Ahan-Trivedi2/mosfet-dac/test_dac1.txt

 yes             code            v(sb0)          v(sb1)          v(sb2)          v(sb3)          v(sb4)          v(sb5)          v(sb6)          i(Viout)        v(Vout)        
 1.00000000e+00  0.00000000e+00  0.00000000e+00  0.00000000e+00  0.00000000e+00  0.00000000e+00  0.00000000e+00  0.00000000e+00  0.00000000e+00  1.82866334e-07  2.00000000e-01 
 1.00000000e+00  1.00000000e+00  1.26118649e+00  0.00000000e+00  0.00000000e+00  0.00000000e+00  0.00000000e+00  0.00000000e+00  0.00000000e+00  1.87715440e-07  2.00000000e-01 
 1.00000000e+00  2.00000000e+00  0.00000000e+00  1.26118647e+00  0.00000000e+00  0.00000000e+00  0.00000000e+00  0.00000000e+00  0.00000000e+00  1.92816409e-07  2.00000000e-01 
 1.00000000e+00  3.00000000e+00  1.26118652e+00  1.26118652e+00  0.00000000e+00  0.00000000e+00  0.00000000e+00  0.00000000e+00  0.00000000e+00  1.97860644e-07  2.00000000e-01 
 1.00000000e+00  4.00000000e+00  0.00000000e+00  0.00000000e+00  1.26118648e+00  0.00000000e+00  0.00000000e+00  0.00000000e+00  0.00000000e+00  2.03180927e-07  2.00000000e-01 
 1.00000000e+00  5.00000000e+00  1.26118653e+00  0.00000000e+00  1.26118653e+00  0.00000000e+00  0.00000000e+00  0.00000000e+00  0.00000000e+00  2.08109976e-07  2.00000000e-01 
 1.00000000e+00  6.00000000e+00  0.00000000e+00  1.26118652e+00  1.26118652e+00  0.00000000e+00  0.00000000e+00  0.00000000e+00  0.00000000e+00  2.13316512e-07  2.00000000e-01 
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
 1.00000000e+00  3.90000000e+01  1.26118661e+00  1.26118661e+00  1.26118661e+00  0.00000000e+00  0.00000000e+00  1.26118661e+00  0.00000000e+00  3.89177282e-07  2.00000000e-01 
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
