Ahan-Trivedi2/mosfet-dac/test_dac10.txt

 yes             code            v(sb0)          v(sb1)          v(sb2)          v(sb3)          v(sb4)          v(sb5)          v(sb6)          i(Viout)        v(Vout)        
 1.00000000e+00  0.00000000e+00  0.00000000e+00  0.00000000e+00  0.00000000e+00  0.00000000e+00  0.00000000e+00  0.00000000e+00  0.00000000e+00  1.34841469e-07  2.00000000e-01 
 1.00000000e+00  1.00000000e+00  1.23102774e+00  0.00000000e+00  0.00000000e+00  0.00000000e+00  0.00000000e+00  0.00000000e+00  0.00000000e+00  1.38862307e-07  2.00000000e-01 
 1.00000000e+00  2.00000000e+00  0.00000000e+00  1.23102773e+00  0.00000000e+00  0.00000000e+00  0.00000000e+00  0.00000000e+00  0.00000000e+00  1.43320082e-07  2.00000000e-01 
 1.00000000e+00  3.00000000e+00  1.23102779e+00  1.23102779e+00  0.00000000e+00  0.00000000e+00  0.00000000e+00  0.00000000e+00  0.00000000e+00  1.47491604e-07  2.00000000e-01 
 1.00000000e+00  4.00000000e+00  0.00000000e+00  0.00000000e+00  1.23102773e+00  0.00000000e+00  0.00000000e+00  0.00000000e+00  0.00000000e+00  1.52126862e-07  2.00000000e-01 
 1.00000000e+00  5.00000000e+00  1.23102779e+00  0.00000000e+00  1.23102779e+00  0.00000000e+00  0.00000000e+00  0.00000000e+00  0.00000000e+00  1.56183434e-07  2.00000000e-01 
 1.00000000e+00  6.00000000e+00  0.00000000e+00  1.23102778e+00  1.23102778e+00  0.00000000e+00  0.00000000e+00  0.00000000e+00  0.00000000e+00  1.60726109e-07  2.00000000e-01 
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
 1.00000000e+00  3.90000000e+01  1.23102789e+00  1.23102789e+00  1.23102789e+00  0.00000000e+00  0.00000000e+00  1.23102789e+00  0.00000000e+00  3.08332166e-07  2.00000000e-01 
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
