Ahan-Trivedi2/mosfet-dac/test_dac2.txt

 yes             code            v(sb0)          v(sb1)          v(sb2)          v(sb3)          v(sb4)          v(sb5)          v(sb6)          i(Viout)        v(Vout)        
 1.00000000e+00  0.00000000e+00  0.00000000e+00  0.00000000e+00  0.00000000e+00  0.00000000e+00  0.00000000e+00  0.00000000e+00  0.00000000e+00  8.42489442e-08  2.00000000e-01 
 1.00000000e+00  1.00000000e+00  1.17058799e+00  0.00000000e+00  0.00000000e+00  0.00000000e+00  0.00000000e+00  0.00000000e+00  0.00000000e+00  8.35890432e-08  2.00000000e-01 
 1.00000000e+00  2.00000000e+00  0.00000000e+00  1.17058798e+00  0.00000000e+00  0.00000000e+00  0.00000000e+00  0.00000000e+00  0.00000000e+00  8.59487441e-08  2.00000000e-01 
 1.00000000e+00  3.00000000e+00  1.17058807e+00  1.17058807e+00  0.00000000e+00  0.00000000e+00  0.00000000e+00  0.00000000e+00  0.00000000e+00  8.67917785e-08  2.00000000e-01 
 1.00000000e+00  4.00000000e+00  0.00000000e+00  0.00000000e+00  1.17058799e+00  0.00000000e+00  0.00000000e+00  0.00000000e+00  0.00000000e+00  9.05680955e-08  2.00000000e-01 
 1.00000000e+00  5.00000000e+00  1.17058808e+00  0.00000000e+00  1.17058808e+00  0.00000000e+00  0.00000000e+00  0.00000000e+00  0.00000000e+00  9.06353794e-08  2.00000000e-01 
 1.00000000e+00  6.00000000e+00  0.00000000e+00  1.17058807e+00  1.17058807e+00  0.00000000e+00  0.00000000e+00  0.00000000e+00  0.00000000e+00  9.37514247e-08  2.00000000e-01 
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
 1.00000000e+00  3.90000000e+01  1.17058826e+00  1.17058826e+00  1.17058826e+00  0.00000000e+00  0.00000000e+00  1.17058826e+00  0.00000000e+00  1.68637335e-07  2.00000000e-01 
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
