Ahan-Trivedi2/mosfet-dac/test_dac3.txt

 yes             code            v(sb0)          v(sb1)          v(sb2)          v(sb3)          v(sb4)          v(sb5)          v(sb6)          i(Viout)        v(Vout)        
 1.00000000e+00  0.00000000e+00  0.00000000e+00  0.00000000e+00  0.00000000e+00  0.00000000e+00  0.00000000e+00  0.00000000e+00  0.00000000e+00  1.59955095e-07  2.00000000e-01 
 1.00000000e+00  1.00000000e+00  1.25888984e+00  0.00000000e+00  0.00000000e+00  0.00000000e+00  0.00000000e+00  0.00000000e+00  0.00000000e+00  1.62700293e-07  2.00000000e-01 
 1.00000000e+00  2.00000000e+00  0.00000000e+00  1.25888984e+00  0.00000000e+00  0.00000000e+00  0.00000000e+00  0.00000000e+00  0.00000000e+00  1.68397689e-07  2.00000000e-01 
 1.00000000e+00  3.00000000e+00  1.25888988e+00  1.25888988e+00  0.00000000e+00  0.00000000e+00  0.00000000e+00  0.00000000e+00  0.00000000e+00  1.72478815e-07  2.00000000e-01 
 1.00000000e+00  4.00000000e+00  0.00000000e+00  0.00000000e+00  1.25888984e+00  0.00000000e+00  0.00000000e+00  0.00000000e+00  0.00000000e+00  1.79533950e-07  2.00000000e-01 
 1.00000000e+00  5.00000000e+00  1.25888988e+00  0.00000000e+00  1.25888988e+00  0.00000000e+00  0.00000000e+00  0.00000000e+00  0.00000000e+00  1.82899106e-07  2.00000000e-01 
 1.00000000e+00  6.00000000e+00  0.00000000e+00  1.25888988e+00  1.25888988e+00  0.00000000e+00  0.00000000e+00  0.00000000e+00  0.00000000e+00  1.89250864e-07  2.00000000e-01 
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
 1.00000000e+00  3.90000000e+01  1.25888996e+00  1.25888996e+00  1.25888996e+00  0.00000000e+00  0.00000000e+00  1.25888996e+00  0.00000000e+00  3.68475863e-07  2.00000000e-01 
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
