Ahan-Trivedi2/mosfet-dac/test_dac4.txt

 yes             code            v(sb0)          v(sb1)          v(sb2)          v(sb3)          v(sb4)          v(sb5)          v(sb6)          i(Viout)        v(Vout)        
 1.00000000e+00  0.00000000e+00  0.00000000e+00  0.00000000e+00  0.00000000e+00  0.00000000e+00  0.00000000e+00  0.00000000e+00  0.00000000e+00  1.81093937e-07  2.00000000e-01 
 1.00000000e+00  1.00000000e+00  1.24883757e+00  0.00000000e+00  0.00000000e+00  0.00000000e+00  0.00000000e+00  0.00000000e+00  0.00000000e+00  1.93640272e-07  2.00000000e-01 
 1.00000000e+00  2.00000000e+00  0.00000000e+00  1.24883757e+00  0.00000000e+00  0.00000000e+00  0.00000000e+00  0.00000000e+00  0.00000000e+00  1.98269781e-07  2.00000000e-01 
 1.00000000e+00  3.00000000e+00  1.24883763e+00  1.24883763e+00  0.00000000e+00  0.00000000e+00  0.00000000e+00  0.00000000e+00  0.00000000e+00  2.06794864e-07  2.00000000e-01 
 1.00000000e+00  4.00000000e+00  0.00000000e+00  0.00000000e+00  1.24883757e+00  0.00000000e+00  0.00000000e+00  0.00000000e+00  0.00000000e+00  2.07263137e-07  2.00000000e-01 
 1.00000000e+00  5.00000000e+00  1.24883762e+00  0.00000000e+00  1.24883762e+00  0.00000000e+00  0.00000000e+00  0.00000000e+00  0.00000000e+00  2.17762711e-07  2.00000000e-01 
 1.00000000e+00  6.00000000e+00  0.00000000e+00  1.24883762e+00  1.24883762e+00  0.00000000e+00  0.00000000e+00  0.00000000e+00  0.00000000e+00  2.20367754e-07  2.00000000e-01 
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
 1.00000000e+00  3.90000000e+01  1.24883772e+00  1.24883772e+00  1.24883772e+00  0.00000000e+00  0.00000000e+00  1.24883772e+00  0.00000000e+00  3.80235184e-07  2.00000000e-01 
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
