Ahan-Trivedi2/mosfet-dac/test_dac5.txt

 yes             code            v(sb0)          v(sb1)          v(sb2)          v(sb3)          v(sb4)          v(sb5)          v(sb6)          i(Viout)        v(Vout)        
 1.00000000e+00  0.00000000e+00  0.00000000e+00  0.00000000e+00  0.00000000e+00  0.00000000e+00  0.00000000e+00  0.00000000e+00  0.00000000e+00  1.21390231e-07  2.00000000e-01 
 1.00000000e+00  1.00000000e+00  1.21446133e+00  0.00000000e+00  0.00000000e+00  0.00000000e+00  0.00000000e+00  0.00000000e+00  0.00000000e+00  1.25894581e-07  2.00000000e-01 
 1.00000000e+00  2.00000000e+00  0.00000000e+00  1.21446134e+00  0.00000000e+00  0.00000000e+00  0.00000000e+00  0.00000000e+00  0.00000000e+00  1.29960938e-07  2.00000000e-01 
 1.00000000e+00  3.00000000e+00  1.21446141e+00  1.21446141e+00  0.00000000e+00  0.00000000e+00  0.00000000e+00  0.00000000e+00  0.00000000e+00  1.34197710e-07  2.00000000e-01 
 1.00000000e+00  4.00000000e+00  0.00000000e+00  0.00000000e+00  1.21446133e+00  0.00000000e+00  0.00000000e+00  0.00000000e+00  0.00000000e+00  1.38080610e-07  2.00000000e-01 
 1.00000000e+00  5.00000000e+00  1.21446140e+00  0.00000000e+00  1.21446140e+00  0.00000000e+00  0.00000000e+00  0.00000000e+00  0.00000000e+00  1.42436621e-07  2.00000000e-01 
 1.00000000e+00  6.00000000e+00  0.00000000e+00  1.21446141e+00  1.21446141e+00  0.00000000e+00  0.00000000e+00  0.00000000e+00  0.00000000e+00  1.46400872e-07  2.00000000e-01 
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
 1.00000000e+00  3.90000000e+01  1.21446154e+00  1.21446154e+00  1.21446154e+00  0.00000000e+00  0.00000000e+00  1.21446154e+00  0.00000000e+00  2.79807840e-07  2.00000000e-01 
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
