Ahan-Trivedi2/mosfet-dac/test_dac6.txt

 yes             code            v(sb0)          v(sb1)          v(sb2)          v(sb3)          v(sb4)          v(sb5)          v(sb6)          i(Viout)        v(Vout)        
 1.00000000e+00  0.00000000e+00  0.00000000e+00  0.00000000e+00  0.00000000e+00  0.00000000e+00  0.00000000e+00  0.00000000e+00  0.00000000e+00  1.58881035e-07  2.00000000e-01 
 1.00000000e+00  1.00000000e+00  1.22881268e+00  0.00000000e+00  0.00000000e+00  0.00000000e+00  0.00000000e+00  0.00000000e+00  0.00000000e+00  1.68561448e-07  2.00000000e-01 
 1.00000000e+00  2.00000000e+00  0.00000000e+00  1.22881269e+00  0.00000000e+00  0.00000000e+00  0.00000000e+00  0.00000000e+00  0.00000000e+00  1.73556550e-07  2.00000000e-01 
 1.00000000e+00  3.00000000e+00  1.22881275e+00  1.22881275e+00  0.00000000e+00  0.00000000e+00  0.00000000e+00  0.00000000e+00  0.00000000e+00  1.80747000e-07  2.00000000e-01 
 1.00000000e+00  4.00000000e+00  0.00000000e+00  0.00000000e+00  1.22881269e+00  0.00000000e+00  0.00000000e+00  0.00000000e+00  0.00000000e+00  1.83024249e-07  2.00000000e-01 
 1.00000000e+00  5.00000000e+00  1.22881275e+00  0.00000000e+00  1.22881275e+00  0.00000000e+00  0.00000000e+00  0.00000000e+00  0.00000000e+00  1.91418628e-07  2.00000000e-01 
 1.00000000e+00  6.00000000e+00  0.00000000e+00  1.22881275e+00  1.22881275e+00  0.00000000e+00  0.00000000e+00  0.00000000e+00  0.00000000e+00  1.95150140e-07  2.00000000e-01 
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
 1.00000000e+00  3.90000000e+01  1.22881287e+00  1.22881287e+00  1.22881287e+00  0.00000000e+00  0.00000000e+00  1.22881287e+00  0.00000000e+00  3.58199999e-07  2.00000000e-01 
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
