Ahan-Trivedi2/mosfet-dac/test_dac7.txt

 yes             code            v(sb0)          v(sb1)          v(sb2)          v(sb3)          v(sb4)          v(sb5)          v(sb6)          i(Viout)        v(Vout)        
 1.00000000e+00  0.00000000e+00  0.00000000e+00  0.00000000e+00  0.00000000e+00  0.00000000e+00  0.00000000e+00  0.00000000e+00  0.00000000e+00  1.02766307e-07  2.00000000e-01 
 1.00000000e+00  1.00000000e+00  1.21017165e+00  0.00000000e+00  0.00000000e+00  0.00000000e+00  0.00000000e+00  0.00000000e+00  0.00000000e+00  1.06180499e-07  2.00000000e-01 
 1.00000000e+00  2.00000000e+00  0.00000000e+00  1.21017165e+00  0.00000000e+00  0.00000000e+00  0.00000000e+00  0.00000000e+00  0.00000000e+00  1.09578993e-07  2.00000000e-01 
 1.00000000e+00  3.00000000e+00  1.21017172e+00  1.21017172e+00  0.00000000e+00  0.00000000e+00  0.00000000e+00  0.00000000e+00  0.00000000e+00  1.12960040e-07  2.00000000e-01 
 1.00000000e+00  4.00000000e+00  0.00000000e+00  0.00000000e+00  1.21017166e+00  0.00000000e+00  0.00000000e+00  0.00000000e+00  0.00000000e+00  1.16201464e-07  2.00000000e-01 
 1.00000000e+00  5.00000000e+00  1.21017173e+00  0.00000000e+00  1.21017173e+00  0.00000000e+00  0.00000000e+00  0.00000000e+00  0.00000000e+00  1.19578750e-07  2.00000000e-01 
 1.00000000e+00  6.00000000e+00  0.00000000e+00  1.21017173e+00  1.21017173e+00  0.00000000e+00  0.00000000e+00  0.00000000e+00  0.00000000e+00  1.22970527e-07  2.00000000e-01 
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
 1.00000000e+00  3.90000000e+01  1.21017187e+00  1.21017187e+00  1.21017187e+00  0.00000000e+00  0.00000000e+00  1.21017187e+00  0.00000000e+00  2.36843000e-07  2.00000000e-01 
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
