Ahan-Trivedi2/mosfet-dac/test_dac8.txt

 yes             code            v(sb0)          v(sb1)          v(sb2)          v(sb3)          v(sb4)          v(sb5)          v(sb6)          i(Viout)        v(Vout)        
 1.00000000e+00  0.00000000e+00  0.00000000e+00  0.00000000e+00  0.00000000e+00  0.00000000e+00  0.00000000e+00  0.00000000e+00  0.00000000e+00  7.30745766e-08  2.00000000e-01 
 1.00000000e+00  1.00000000e+00  1.16392115e+00  0.00000000e+00  0.00000000e+00  0.00000000e+00  0.00000000e+00  0.00000000e+00  0.00000000e+00  8.00860189e-08  2.00000000e-01 
 1.00000000e+00  2.00000000e+00  0.00000000e+00  1.16392114e+00  0.00000000e+00  0.00000000e+00  0.00000000e+00  0.00000000e+00  0.00000000e+00  8.24846999e-08  2.00000000e-01 
 1.00000000e+00  3.00000000e+00  1.16392125e+00  1.16392125e+00  0.00000000e+00  0.00000000e+00  0.00000000e+00  0.00000000e+00  0.00000000e+00  8.71285834e-08  2.00000000e-01 
 1.00000000e+00  4.00000000e+00  0.00000000e+00  0.00000000e+00  1.16392117e+00  0.00000000e+00  0.00000000e+00  0.00000000e+00  0.00000000e+00  8.69900890e-08  2.00000000e-01 
 1.00000000e+00  5.00000000e+00  1.16392128e+00  0.00000000e+00  1.16392128e+00  0.00000000e+00  0.00000000e+00  0.00000000e+00  0.00000000e+00  9.27877865e-08  2.00000000e-01 
 1.00000000e+00  6.00000000e+00  0.00000000e+00  1.16392127e+00  1.16392127e+00  0.00000000e+00  0.00000000e+00  0.00000000e+00  0.00000000e+00  9.40263449e-08  2.00000000e-01 
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
 1.00000000e+00  3.90000000e+01  1.16392150e+00  1.16392150e+00  1.16392150e+00  0.00000000e+00  0.00000000e+00  1.16392150e+00  0.00000000e+00  1.75861840e-07  2.00000000e-01 
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
