Ahan-Trivedi2/mosfet-dac/test_dac9.txt

 yes             code            v(sb0)          v(sb1)          v(sb2)          v(sb3)          v(sb4)          v(sb5)          v(sb6)          i(Viout)        v(Vout)        
 1.00000000e+00  0.00000000e+00  0.00000000e+00  0.00000000e+00  0.00000000e+00  0.00000000e+00  0.00000000e+00  0.00000000e+00  0.00000000e+00  1.48712208e-07  2.00000000e-01 
 1.00000000e+00  1.00000000e+00  1.24040824e+00  0.00000000e+00  0.00000000e+00  0.00000000e+00  0.00000000e+00  0.00000000e+00  0.00000000e+00  1.52369784e-07  2.00000000e-01 
 1.00000000e+00  2.00000000e+00  0.00000000e+00  1.24040823e+00  0.00000000e+00  0.00000000e+00  0.00000000e+00  0.00000000e+00  0.00000000e+00  1.56613848e-07  2.00000000e-01 
 1.00000000e+00  3.00000000e+00  1.24040829e+00  1.24040829e+00  0.00000000e+00  0.00000000e+00  0.00000000e+00  0.00000000e+00  0.00000000e+00  1.60579069e-07  2.00000000e-01 
 1.00000000e+00  4.00000000e+00  0.00000000e+00  0.00000000e+00  1.24040823e+00  0.00000000e+00  0.00000000e+00  0.00000000e+00  0.00000000e+00  1.65175003e-07  2.00000000e-01 
 1.00000000e+00  5.00000000e+00  1.24040829e+00  0.00000000e+00  1.24040829e+00  0.00000000e+00  0.00000000e+00  0.00000000e+00  0.00000000e+00  1.68954576e-07  2.00000000e-01 
 1.00000000e+00  6.00000000e+00  0.00000000e+00  1.24040828e+00  1.24040828e+00  0.00000000e+00  0.00000000e+00  0.00000000e+00  0.00000000e+00  1.73369056e-07  2.00000000e-01 
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
 1.00000000e+00  3.90000000e+01  1.24040839e+00  1.24040839e+00  1.24040839e+00  0.00000000e+00  0.00000000e+00  1.24040839e+00  0.00000000e+00  3.12002573e-07  2.00000000e-01 
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
