Ahan-Trivedi2/mosfet-dac/test_dac.txt

 yes             code            v(sb0)          v(sb1)          v(sb2)          v(sb3)          v(sb4)          v(sb5)          v(sb6)          i(Viout)        v(Vout)        
 1.00000000e+00  0.00000000e+00  0.00000000e+00  0.00000000e+00  0.00000000e+00  0.00000000e+00  0.00000000e+00  0.00000000e+00  0.00000000e+00  3.59493950e-10  2.00000000e-01 
 1.00000000e+00  1.00000000e+00  1.51745145e+00  0.00000000e+00  0.00000000e+00  0.00000000e+00  0.00000000e+00  0.00000000e+00  0.00000000e+00  3.09331017e-09  2.00000000e-01 
 1.00000000e+00  2.00000000e+00  0.00000000e+00  1.51745145e+00  0.00000000e+00  0.00000000e+00  0.00000000e+00  0.00000000e+00  0.00000000e+00  4.23312922e-09  2.00000000e-01 
 1.00000000e+00  3.00000000e+00  1.51739240e+00  1.51739240e+00  0.00000000e+00  0.00000000e+00  0.00000000e+00  0.00000000e+00  0.00000000e+00  6.12834498e-09  2.00000000e-01 
 1.00000000e+00  4.00000000e+00  0.00000000e+00  0.00000000e+00  1.51745145e+00  0.00000000e+00  0.00000000e+00  0.00000000e+00  0.00000000e+00  6.53005358e-09  2.00000000e-01 
 1.00000000e+00  5.00000000e+00  1.51739240e+00  0.00000000e+00  1.51739240e+00  0.00000000e+00  0.00000000e+00  0.00000000e+00  0.00000000e+00  8.75058792e-09  2.00000000e-01 
 1.00000000e+00  6.00000000e+00  0.00000000e+00  1.51739240e+00  1.51739240e+00  0.00000000e+00  0.00000000e+00  0.00000000e+00  0.00000000e+00  9.53968253e-09  2.00000000e-01 
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
 1.00000000e+00  3.90000000e+01  1.51727429e+00  1.51727429e+00  1.51727429e+00  0.00000000e+00  0.00000000e+00  1.51727429e+00  0.00000000e+00  4.82192454e-08  2.00000000e-01 
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
