Ahan-Trivedi2/mosfet-dac/layout/bbg.spice

.subckt bbg VP VBP VBN VN RES
X0 VN a_460_n780# a_n200_n840# VN sky130_fd_pr__nfet_01v8 ad=0.5 pd=3 as=0.5 ps=3 w=1 l=1
X1 a_460_n780# VBP VP VP sky130_fd_pr__pfet_01v8 ad=0.5 pd=3 as=0.5 ps=3 w=1 l=1
X2 a_460_n780# a_460_n780# RES VN sky130_fd_pr__nfet_01v8 ad=0.5 pd=3 as=0.5 ps=3 w=1 l=1
X3 VP VBP a_460_n780# VP sky130_fd_pr__pfet_01v8 ad=0.5 pd=3 as=0.5 ps=3 w=1 l=1
X4 a_n200_n840# a_460_n780# VN VN sky130_fd_pr__nfet_01v8 ad=0.5 pd=3 as=0.5 ps=3 w=1 l=1
X5 VP a_n200_n840# a_n200_n840# VP sky130_fd_pr__pfet_01v8 ad=0.5 pd=3 as=0.5 ps=3 w=1 l=1
X6 VN VBN VBP VN sky130_fd_pr__nfet_01v8 ad=0.5 pd=3 as=0.5 ps=3 w=1 l=1
X7 VBP a_n200_n840# VP VP sky130_fd_pr__pfet_01v8 ad=0.5 pd=3 as=0.5 ps=3 w=1 l=1
X8 VBN VBP VP VP sky130_fd_pr__pfet_01v8 ad=0.5 pd=3 as=0.5 ps=3 w=1 l=1
X9 a_n200_n840# a_460_n780# VN VN sky130_fd_pr__nfet_01v8 ad=0.5 pd=3 as=0.5 ps=3 w=1 l=1
X10 RES a_460_n780# a_460_n780# VN sky130_fd_pr__nfet_01v8 ad=0.5 pd=3 as=0.5 ps=3 w=1 l=1
X11 VP VBP VBN VP sky130_fd_pr__pfet_01v8 ad=0.5 pd=3 as=0.5 ps=3 w=1 l=1
X12 VP VBP VBN VP sky130_fd_pr__pfet_01v8 ad=0.5 pd=3 as=0.5 ps=3 w=1 l=1
X13 VBP a_n200_n840# VP VP sky130_fd_pr__pfet_01v8 ad=0.5 pd=3 as=0.5 ps=3 w=1 l=1
X14 a_n200_n840# a_n200_n840# VP VP sky130_fd_pr__pfet_01v8 ad=0.5 pd=3 as=0.5 ps=3 w=1 l=1
X15 VBP VBN VN VN sky130_fd_pr__nfet_01v8 ad=0.5 pd=3 as=0.5 ps=3 w=1 l=1
X16 a_460_n780# VBP VP VP sky130_fd_pr__pfet_01v8 ad=0.5 pd=3 as=0.5 ps=3 w=1 l=1
X17 a_460_n780# a_460_n780# RES VN sky130_fd_pr__nfet_01v8 ad=0.5 pd=3 as=0.5 ps=3 w=1 l=1
X18 VP VBP a_460_n780# VP sky130_fd_pr__pfet_01v8 ad=0.5 pd=3 as=0.5 ps=3 w=1 l=1
X19 VBN VBN VN VN sky130_fd_pr__nfet_01v8 ad=0.5 pd=3 as=0.5 ps=3 w=1 l=1
X20 VBN VBN VN VN sky130_fd_pr__nfet_01v8 ad=0.5 pd=3 as=0.5 ps=3 w=1 l=1
X21 VP a_n200_n840# a_n200_n840# VP sky130_fd_pr__pfet_01v8 ad=0.5 pd=3 as=0.5 ps=3 w=1 l=1
X22 VN VBN VBP VN sky130_fd_pr__nfet_01v8 ad=0.5 pd=3 as=0.5 ps=3 w=1 l=1
X23 RES a_460_n780# a_460_n780# VN sky130_fd_pr__nfet_01v8 ad=0.5 pd=3 as=0.5 ps=3 w=1 l=1
X24 VN VBN VBN VN sky130_fd_pr__nfet_01v8 ad=0.5 pd=3 as=0.5 ps=3 w=1 l=1
X25 VP a_n200_n840# VBP VP sky130_fd_pr__pfet_01v8 ad=0.5 pd=3 as=0.5 ps=3 w=1 l=1
X26 VP a_n200_n840# VBP VP sky130_fd_pr__pfet_01v8 ad=0.5 pd=3 as=0.5 ps=3 w=1 l=1
X27 VN VBN VBN VN sky130_fd_pr__nfet_01v8 ad=0.5 pd=3 as=0.5 ps=3 w=1 l=1
X28 VN a_460_n780# a_n200_n840# VN sky130_fd_pr__nfet_01v8 ad=0.5 pd=3 as=0.5 ps=3 w=1 l=1
X29 VBP VBN VN VN sky130_fd_pr__nfet_01v8 ad=0.5 pd=3 as=0.5 ps=3 w=1 l=1
X30 VBN VBP VP VP sky130_fd_pr__pfet_01v8 ad=0.5 pd=3 as=0.5 ps=3 w=1 l=1
X31 a_n200_n840# a_n200_n840# VP VP sky130_fd_pr__pfet_01v8 ad=0.5 pd=3 as=0.5 ps=3 w=1 l=1
.ends
.end
