Ahan-Trivedi2/mosfet-dac/layout/bbg_xschem.spice

** sch_path: /home/madvlsi/Documents/mosfet-dac/bbg.sch
**.subckt bbg
XM1 net2 net2 net1 GND sky130_fd_pr__nfet_01v8 L={bbg_len} W={a}*{bbg_wid} nf=1 ad='int((nf+1)/2) * W/nf * 0.29' as='int((nf+2)/2) * W/nf * 0.29'
+ pd='2*int((nf+1)/2) * (W/nf + 0.29)' ps='2*int((nf+2)/2) * (W/nf + 0.29)' nrd='0.29 / W' nrs='0.29 / W' sa=0 sb=0 sd=0 mult=1 m=1
XM2 net3 net2 GND GND sky130_fd_pr__nfet_01v8 L={bbg_len} W={bbg_wid} nf=1 ad='int((nf+1)/2) * W/nf * 0.29' as='int((nf+2)/2) * W/nf * 0.29'
+ pd='2*int((nf+1)/2) * (W/nf + 0.29)' ps='2*int((nf+2)/2) * (W/nf + 0.29)' nrd='0.29 / W' nrs='0.29 / W' sa=0 sb=0 sd=0 mult=1 m=1
R1 net1 GND 200k m=1
XM3 net2 net5 VDD VDD sky130_fd_pr__pfet_01v8 L={bbg_len} W={bbg_wid} nf=1 ad='int((nf+1)/2) * W/nf * 0.29' as='int((nf+2)/2) * W/nf * 0.29'
+ pd='2*int((nf+1)/2) * (W/nf + 0.29)' ps='2*int((nf+2)/2) * (W/nf + 0.29)' nrd='0.29 / W' nrs='0.29 / W' sa=0 sb=0 sd=0 mult=1 m=1
V1 VDD GND 1.8
Vmeas net6 net4 0
.save i(vmeas)
XM6 GND net4 net5 GND sky130_fd_pr__nfet_01v8 L={bbg_len} W={bbg_wid} nf=1 ad='int((nf+1)/2) * W/nf * 0.29' as='int((nf+2)/2) * W/nf * 0.29'
+ pd='2*int((nf+1)/2) * (W/nf + 0.29)' ps='2*int((nf+2)/2) * (W/nf + 0.29)' nrd='0.29 / W' nrs='0.29 / W' sa=0 sb=0 sd=0 mult=1 m=1
XM7 net4 net4 GND GND sky130_fd_pr__nfet_01v8 L={bbg_len} W={bbg_wid} nf=1 ad='int((nf+1)/2) * W/nf * 0.29' as='int((nf+2)/2) * W/nf * 0.29'
+ pd='2*int((nf+1)/2) * (W/nf + 0.29)' ps='2*int((nf+2)/2) * (W/nf + 0.29)' nrd='0.29 / W' nrs='0.29 / W' sa=0 sb=0 sd=0 mult=1 m=1
XM4 net3 net3 VDD VDD sky130_fd_pr__pfet_01v8 L={bbg_len} W={bbg_wid} nf=1 ad='int((nf+1)/2) * W/nf * 0.29' as='int((nf+2)/2) * W/nf * 0.29'
+ pd='2*int((nf+1)/2) * (W/nf + 0.29)' ps='2*int((nf+2)/2) * (W/nf + 0.29)' nrd='0.29 / W' nrs='0.29 / W' sa=0 sb=0 sd=0 mult=1 m=1
XM5 VDD net3 net5 VDD sky130_fd_pr__pfet_01v8 L={bbg_len} W={bbg_wid} nf=1 ad='int((nf+1)/2) * W/nf * 0.29' as='int((nf+2)/2) * W/nf * 0.29'
+ pd='2*int((nf+1)/2) * (W/nf + 0.29)' ps='2*int((nf+2)/2) * (W/nf + 0.29)' nrd='0.29 / W' nrs='0.29 / W' sa=0 sb=0 sd=0 mult=1 m=1
XM8 VDD net5 net6 VDD sky130_fd_pr__pfet_01v8 L={bbg_len} W={bbg_wid} nf=1 ad='int((nf+1)/2) * W/nf * 0.29' as='int((nf+2)/2) * W/nf * 0.29'
+ pd='2*int((nf+1)/2) * (W/nf + 0.29)' ps='2*int((nf+2)/2) * (W/nf + 0.29)' nrd='0.29 / W' nrs='0.29 / W' sa=0 sb=0 sd=0 mult=1 m=1
**** begin user architecture code


.param bbg_wid=1 bbg_len=0.5 a=2
.dc V1 0 1.8 0.05
.save all

.lib /usr/local/share/pdk/sky130A/libs.tech/combined/sky130.lib.spice tt
**** end user architecture code
**.ends
.GLOBAL GND
.GLOBAL VDD
.end
