Ahan-Trivedi2/mosfet-dac/(commit log)

2025-10-20 Add cascode bias circuit (CBC)
    [cbc.sch]
2025-10-21 Add DAC cells
    [daccell.sch, dacend.sch, inverter.sch]
2025-10-21 bootstrap current bias
    [bootstrapbiasgen.sch]
2025-10-21 Added FVF test+sch+sym and FVF_CCM test
    [FVF.sch, FVF_CCM_test.sch, FVF_test.sch]
2025-10-21 BBG symbol and schematic
    [bbg.sch, test_bbg.sch]
2025-10-21 10/21 Ahan work
    [daccell.sch, fvf.sch, fvfccm.sch, inverter.sch, test_fvf.sch, test_fvfccm.sch]
2025-10-21 10/21 fvfccm.sch
    [fvfccm.sch]
2025-10-21 Rename files
    [bbg.sch, cbc.sch, fvf.sch, test_fvf.sch, test_fvfccm.sch]
2025-10-21 Add cbc and bbg fixed
    [bbg.sch, cbc.sch]
2025-10-21 Add cbc symbol
    [cbc.sch, test_cbc.sch]
2025-10-22 Edit bbg symbol
    [test_bbg.sch]
2025-10-22 Add fvf symbol and testing
    [bbg.sch, cbc.sch, fvf.sch, test_fvf.sch, test_output.sch]
2025-10-22 Add full simulation
    [fvfccm.sch, test_output.sch]
2025-10-23 Debugging the bias current in the ccm...
    [fvf.sch, fvfccm.sch, test_fvfccm.sch, test_output.sch]
2025-10-23 Add working mirror stage
    [cbc.sch, fvfccm.sch, test_cbc.sch, test_fvfccm_2.sch, test_output.sch]
2025-10-23 Start full dac testing
    [dacend.sch, test_dac.sch]
2025-10-23 Continue testing dac
    [test_dac.sch]
2025-10-23 Linearize full dac
    [daccell.sch, dacend.sch, fvfccm.sch, inverter.sch, test_dac_2.sch, test_daccell.sch]
2025-10-24 Fix dac linearity
    [daccell.sch, fvf.sch, fvfccm.sch, ncbc.sch, test_dac.sch, test_dac_3.sch, test_output.sch]
2025-10-24 Add dac working but not linear
    [dac.sch, test_bbg.sch, test_dac_vdd.sch, test_dac_vout.sch]
2025-10-24 Failing power supply test
    [dac.sch, test_dac_vdd.sch, test_dac_vout.sch]
2025-10-25 dac might be working you never know
    [dac.sch, fvf.sch, fvfccm.sch, test_dac.sch, test_dac_vdd.sch]
2025-10-25 Add working dac
    [bbg.sch, cbc.sch, dac.sch, fvf.sch, fvfccm.sch, ncbc.sch, test_bbg.sch, test_dac.sch]
2025-10-25 dac monte-carlos
    [test_dac.sch, test_dac_vdd.sch, test_dac_vout.sch]
2025-10-26 refactor parameters
    [bbg.sch, cbc.sch, dac.sch, fvf.sch, fvfccm.sch, ncbc.sch, test_bbg.sch, test_dac.sch]
2025-10-27 Add dac with new monte carlos
    [daccell.sch, dacend.sch, inverter.sch, test_dac.sch, test_dac_vdd.sch, test_dac_vout.sch]
2025-10-27 Add final dac dnl/inl
    [fvfccm.sch, test_dac_vdd.sch]
2025-10-28 Initial LDS Work
    [LDS_bbg.sch, LDS_ccm_nofvf.sch, LDS_dac.sch, LDS_fvf.sch, LDS_ncbc.sch, LDS_pcbc.sch]
2025-10-28 Finished LDS_dac.sch
    [LDS_dac.sch]
2025-10-28 Reorganized LDS files
    [LDS_bbg.sch, LDS_ccm_nofvf.sch, LDS_dac.sch, LDS_fvf.sch, LDS_ncbc.sch, LDS_pcbc.sch]
2025-11-01 LDS work
    [LDS_dac.sch]
2025-11-01 Refined DAC
    [LDS_dac.sch]
2025-11-01 Start ncbc layout
    [test_dac.sch, test_dac_vout.sch]
2025-11-01 Add ncbc without ports
    [LDS_ncbc.sch]
2025-11-01 Add pcbc without ports
    [LDS_pcbc.sch]
2025-11-02 Add lvs-passing ncbc and pcbc
    [LDS_ncbc.sch, LDS_pcbc.sch]
2025-11-02 Fix size errors in cbc
    [LDS_ccm_nofvf.sch, LDS_ncbc.sch, LDS_pcbc.sch]
2025-11-02 BBG Layout
    [LDS_bbg.sch]
2025-11-02 dac and fvf layout
    [LDS_dac.sch, LDS_fvf.sch]
2025-11-03 LDS Schematic
    [LDS_ccm.sch, LDS_inverter.sch, LDS_mosdac.sch, untitled.sch]
2025-11-03 Add LVS-passing DAC
    [LDS_dac.sch]
2025-11-03 Add inverter layout
    [LDS_inverter.sch, inverter.sch]
2025-11-03 Fix mosdac LDS
    [LDS_bbg.sch, LDS_inverter.sch, LDS_mosdac.sch]
2025-11-03 Reorganized file structure
    [bbg.sch, cbc.sch, dac.sch, daccell.sch, dacend.sch, fvf.sch, fvfccm.sch, inverter.sch]
2025-11-03 Add layout for DAC
    [LDS_inverter.sch, LDS_mosdac.sch, daccell.sch]
2025-11-03 Add final files
    [LDS_ccm.sch, LDS_ccm_nofvf.sch, LDS_fvf.sch, LDS_inverter.sch, LDS_mosdac.sch]
2025-11-30 Revert "Reorganized file structure"
    This reverts commit 1cd40ba0a1e9fd96f6001e5874f5c78d41bec90b.
    [bbg.sch, cbc.sch, dac.sch, daccell.sch, dacend.sch, fvf.sch, fvfccm.sch, inverter.sch]
